aaronbeekay/Battery-balancer/Design/HMI/HMI behavior.xlsx

HMI inputs/outputs
Inputs
 | WAIT | ERROR | CHARGE | BALANCE | CHARGE+BALANCE
MODE SELECT switch (CHARGE / BALANCE / CHARGE + BALANCE) | No effect | No effect | Change mode to selected mode
START pushbutton | Change mode to selected mode | No effect
STOP pushbutton | No effect | No effect | Change mode to WAIT
ERROR pushbutton | No effect | Clear errors Change mode to WAIT | No effect
LCD up | Cycle LCD page up |  | Cycle LCD page up
LCD down | Cycle LCD page down |  | Cycle LCD page down
Outputs
ERROR indicator | Off | On | Off
START indicator | Off | Off | On
STOP indicator | On | On | Off
CHARGE indicator | State controlled by charge controller (green if charge complete; red if charging)
BALANCE indicator | State controlled by balance controller (green if balance complete; red if balancing)
Balancing relays | Disabled | Disabled | Disabled | Enabled | Enabled
Bulk charge | Disabled | Disabled | Enabled | Disabled | Enabled
