aaronbeekay/Battery-balancer/Hardware/Front panel/Calculations/Thermistor calculations.xlsx

Typically the team uses NTC thermistors with parameters similar to the Cantherm CWF1B103H3380: | Thermistor parameters
 | β value | 3380 | K
 | Resistance at 25º C | 10000 | ohm
 | Calculated parameters
 | R_inf | 0.11929 | ohm
We will define a range of temperatures that we expect to measure: | Design temperature range
 | Minimum measurable temperature | -40.00 | ºC
 | Maximum measurable temperature | 125 | ºC
which sets the upper and lower bounds on our thermistor resistance: | Thermistor resistance range
 | Minimum thermistor resistance | 579.9997447 | ohm
 | Maximum thermistor resistance | 235830.7559 | ohm
For now we will hard code our series resistor (we cheated and calculated it in Mathematica) | Scaling resistor
 | Rs (series resistance) | 10000 | ohm
For our first-order RC filter, we should be aware that the effective corner frequency will change with the temperature. We can set a desired corner frequency at the midpoint of our temperature range… | Filter capacitor
 | Desired corner frequency | 1 | Hz
 | at… | 42.5 | ºC
 | Effective input impedance | 3478.48 | ohm
 | Required capacitance | 45.754 | uF
… then check the corner frequency at our temperature limits. | Filter behavior
 | Effective input impedance @ max temp | 548.20 | ohm
 | Effective input impedance @ min temp | 9593.22 | ohm
 | Corner frequency at max temp | 6.345 | Hz
 | Corner frequency at min temp | 0.363 | Hz
Remember -- at minimum, we must always sample above 2x our max corner frequency. And if we don't do any DSP on the microcontroller, we must also send out CAN data at >2x the corner frequency.
