aaronbeekay/Battery-balancer/Hardware/Front panel/Calculations/SPIBRR calculations.xlsx

Sheet: SPICLK
SPIBRR | LOSPCP
 | 000 | 001 | 010 | 011 | 100 | 101 | 110 | 111
 | SYSCLKOUT/1 | SYSCLKOUT/2 | SYSCLKOUT/4 | SYSCLKOUT/6 | SYSCLKOUT/8 | SYSCLKOUT/10 | SYSCLKOUT/12 | SYSCLKOUT/14
3 | 15000000 | 7500000 | 3750000 | 2500000 | 1875000 | 1500000 | 1250000 | 1071428.571
4 | 12000000 | 6000000 | 3000000 | 2000000 | 1500000 | 1200000 | 1000000 | 857142.8571
5 | 10000000 | 5000000 | 2500000 | 1666666.667 | 1250000 | 1000000 | 833333.3333 | 714285.7143
6 | 8571428.571 | 4285714.286 | 2142857.143 | 1428571.429 | 1071428.571 | 857142.8571 | 714285.7143 | 612244.898
7 | 7500000 | 3750000 | 1875000 | 1250000 | 937500 | 750000 | 625000 | 535714.2857
8 | 6666666.667 | 3333333.333 | 1666666.667 | 1111111.111 | 833333.3333 | 666666.6667 | 555555.5556 | 476190.4762
9 | 6000000 | 3000000 | 1500000 | 1000000 | 750000 | 600000 | 500000 | 428571.4286
10 | 5454545.455 | 2727272.727 | 1363636.364 | 909090.9091 | 681818.1818 | 545454.5455 | 454545.4545 | 389610.3896
11 | 5000000 | 2500000 | 1250000 | 833333.3333 | 625000 | 500000 | 416666.6667 | 357142.8571
12 | 4615384.615 | 2307692.308 | 1153846.154 | 769230.7692 | 576923.0769 | 461538.4615 | 384615.3846 | 329670.3297
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
