aaronbeekay/Battery-balancer/CAD/Front panel/Front panel subcomponents/GPB527C2L02BG1 switch components/side view.PNG

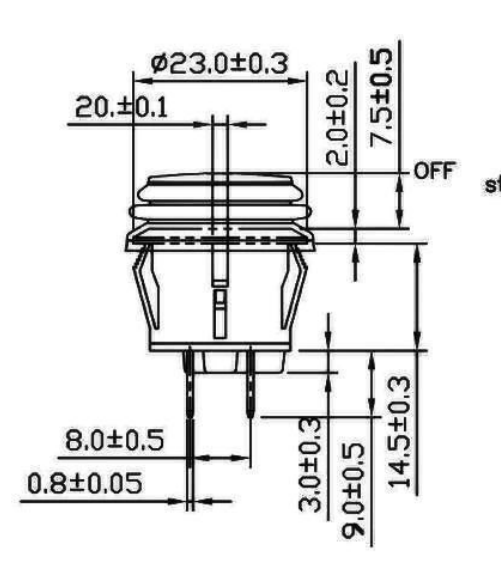
CAD/Front panel/Front panel subcomponents/GPB527C2L02BG1 switch components/side view.PNG
