aaronbeekay/Battery-balancer/CAD/Front panel/Front panel.SLDASM

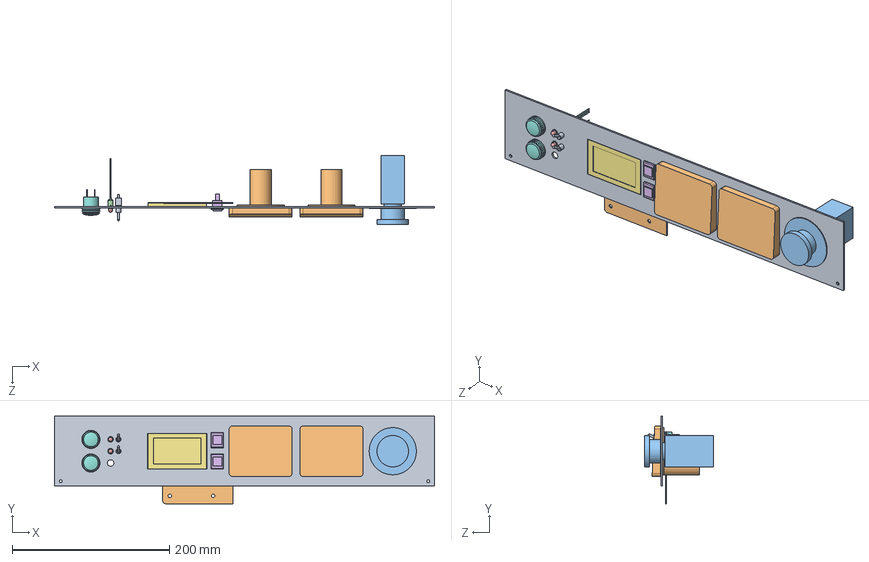
[picture p2: CAD file, 2016-03-22]
CAD/Front panel/Front panel.SLDASM
482.6 x 111.2 x 87.5 mm
Front panel
Front panel PCB
GCX3131 E-stop button
PM5-3_A1 x 2
LED_5mm x 2
TP11J81ZQE22 pushbutton x 2
LCD
GPB527C2L02BG1 pushbutton switch x 2
M2011SS1W01 toggle switch x 2
Panel meter PM89 x 2
