aaronbeekay/Battery-balancer/CAD/Balancer/Electrical components/SUNON Fan Assembly.SLDASM

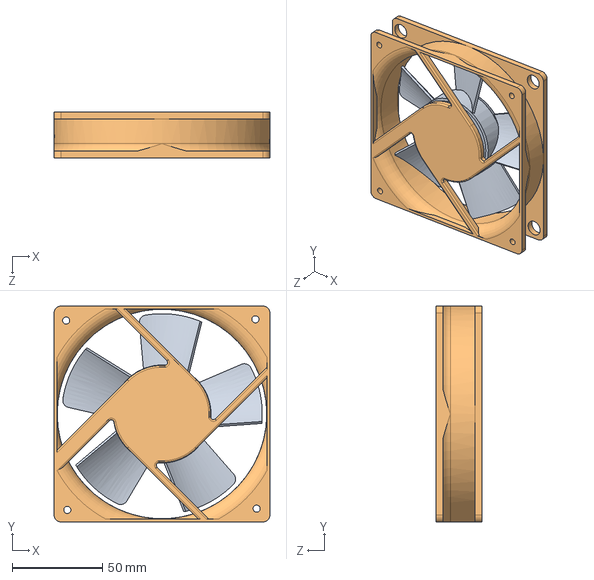
[picture p4: CAD file, 2016-03-11]
CAD/Balancer/Electrical components/SUNON Fan Assembly.SLDASM
119.8 x 119.8 x 25.6 mm
Fan
Fan Housing
