aaronbeekay/Battery-balancer/CAD/Front panel/Front panel subcomponents/PM53-YGW12.0 LED indicator.SLDASM

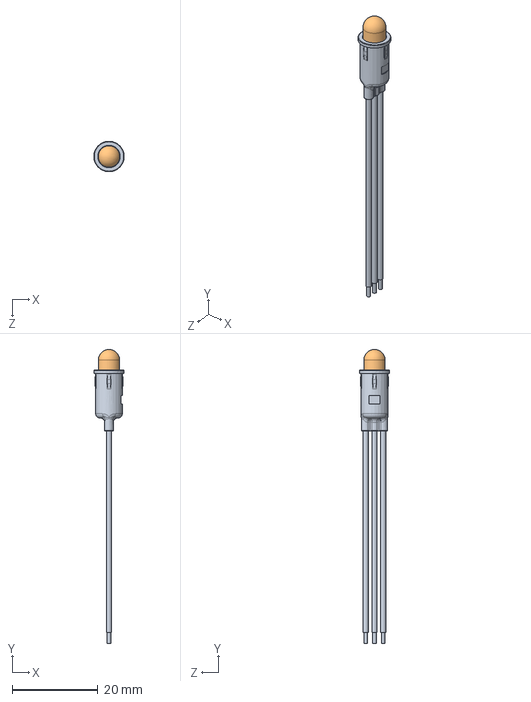
[picture p7: CAD file, 2016-01-27]
CAD/Front panel/Front panel subcomponents/PM53-YGW12.0 LED indicator.SLDASM
7.11 x 68.6 x 7.11 mm
PM5-3_A1
LED_5mm
