aaronbeekay/Battery-balancer/CAD/Balancer/Electrical components/Ohmite L25J1R0E.SLDPRT

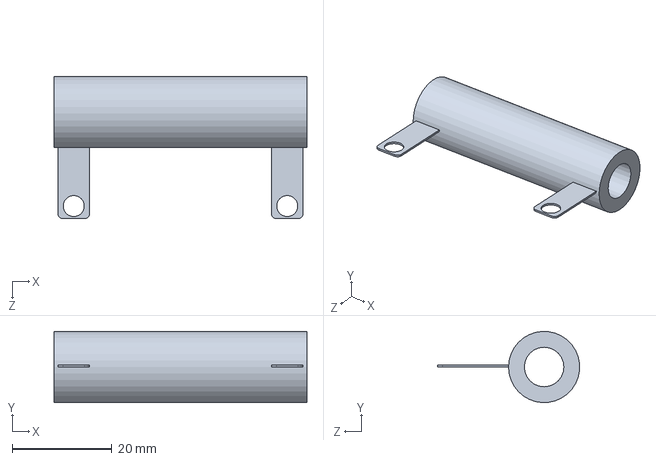
[picture p8: CAD file, 2016-03-11]
CAD/Balancer/Electrical components/Ohmite L25J1R0E.SLDPRT
50.8 x 14.3 x 28.6 mm
