aaronbeekay/Battery-balancer/CAD/Balancer/Structural components/Resistor side wall.SLDPRT

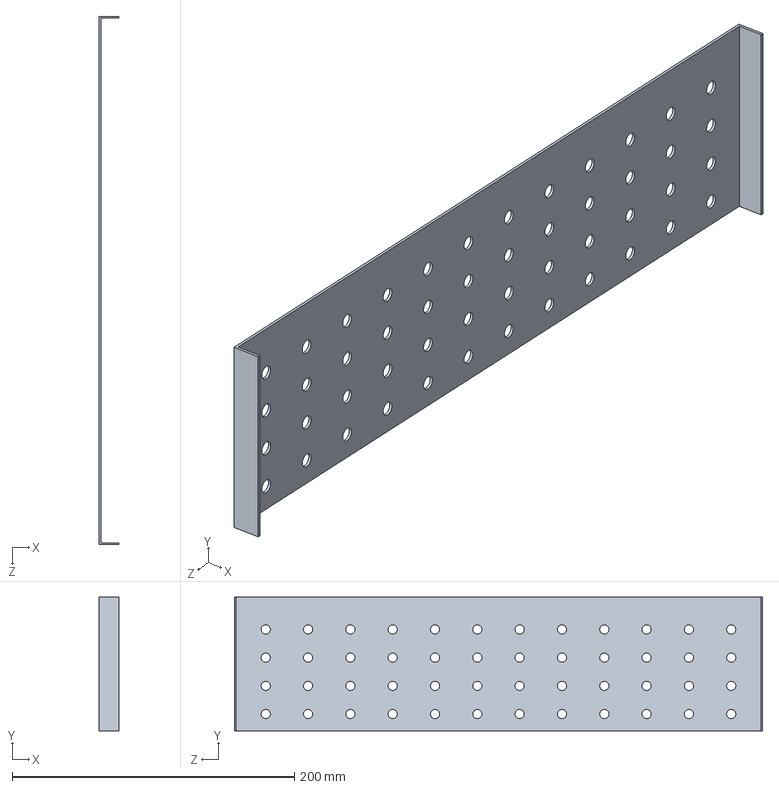
[picture p9: CAD file, 2016-03-11]
CAD/Balancer/Structural components/Resistor side wall.SLDPRT
14.0 x 95.0 x 374.5 mm
