aaronbeekay/Battery-balancer/CAD/Front panel/Front panel subcomponents/Front panel PCB subcomponents/B4B-XH-A 4pos vert.SLDPRT

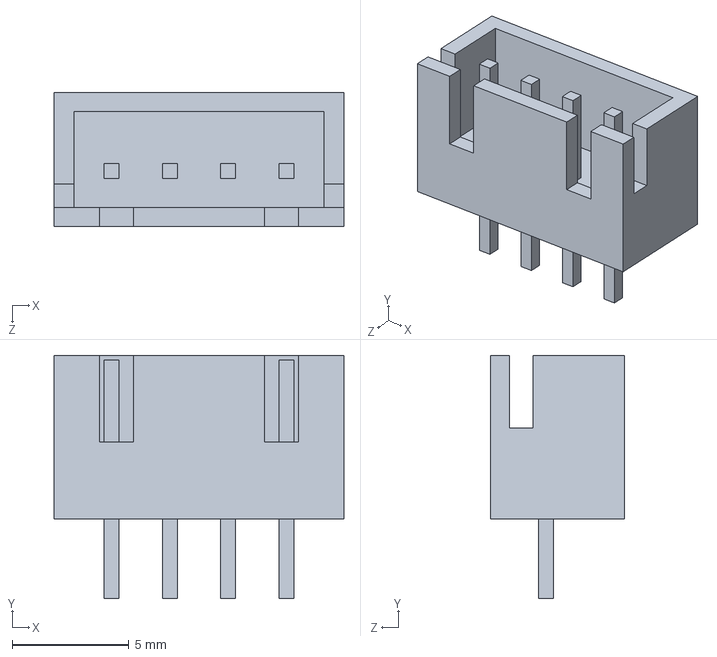
[picture p10: CAD file, 2016-03-11]
CAD/Front panel/Front panel subcomponents/Front panel PCB subcomponents/B4B-XH-A 4pos vert.SLDPRT
12.4 x 10.4 x 5.75 mm
