aaronbeekay/Battery-balancer/CAD/Front panel/Front panel subcomponents/Front panel.SLDPRT

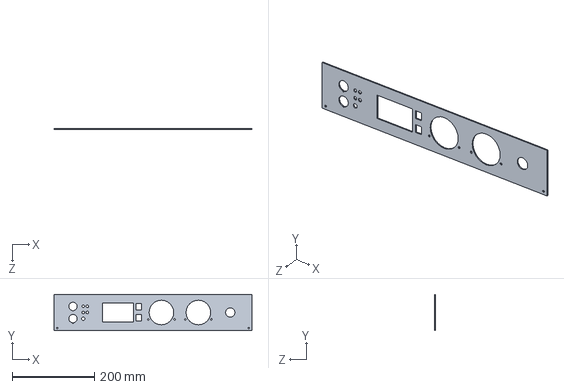
[picture p11: CAD file, 2016-03-22]
CAD/Front panel/Front panel subcomponents/Front panel.SLDPRT
482.6 x 88.9 x 2.10 mm
