aaronbeekay/Battery-balancer/CAD/Front panel/Printing subcomponents/Foot thing.SLDPRT

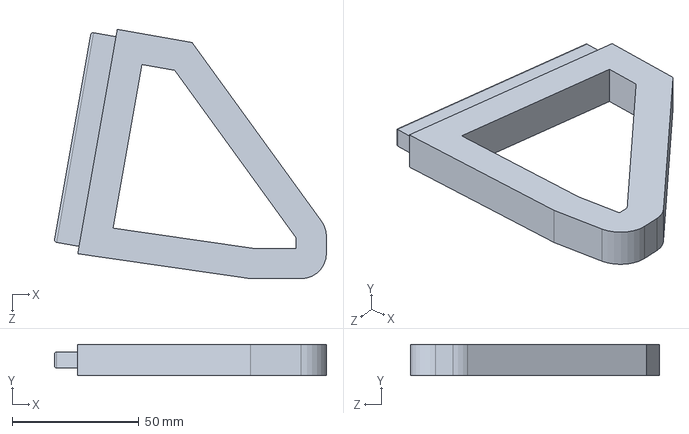
[picture p12: CAD file, 2016-03-11]
CAD/Front panel/Printing subcomponents/Foot thing.SLDPRT
107.4 x 12.2 x 98.5 mm
