aaronbeekay/Battery-balancer/CAD/Front panel/Front panel subcomponents/Front panel PCB subcomponents/B2B-XH-A 2pos vert.SLDPRT

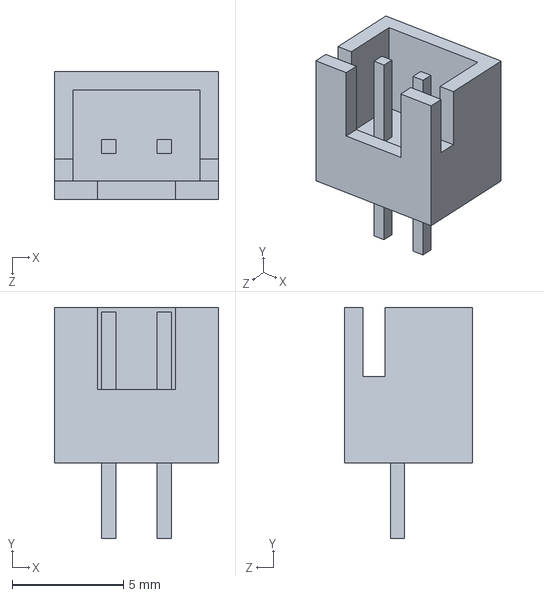
[picture p13: CAD file, 2016-03-11]
CAD/Front panel/Front panel subcomponents/Front panel PCB subcomponents/B2B-XH-A 2pos vert.SLDPRT
7.40 x 10.4 x 5.75 mm
