aaronbeekay/Battery-balancer/CAD/Front panel/Front panel subcomponents/Panel meter PM89.SLDPRT

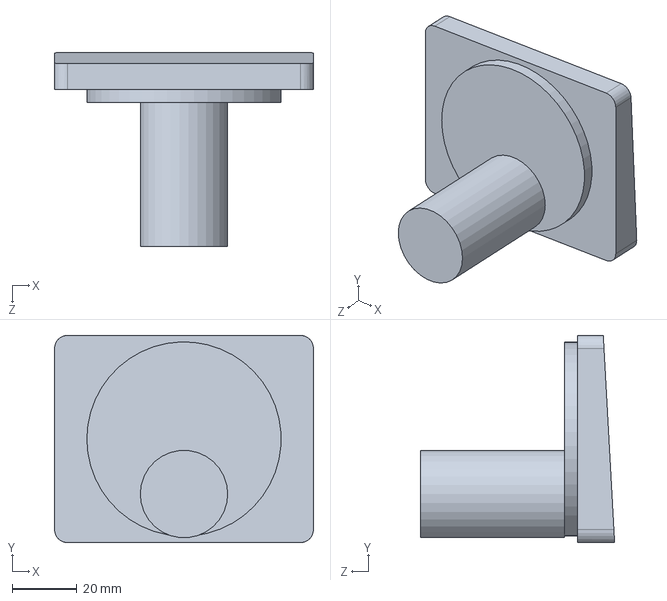
[picture p14: CAD file, 2016-03-22]
CAD/Front panel/Front panel subcomponents/Panel meter PM89.SLDPRT
80.0 x 64.0 x 60.0 mm
