aaronbeekay/Battery-balancer/CAD/Front panel/Front panel subcomponents/Front panel PCB mount.SLDPRT

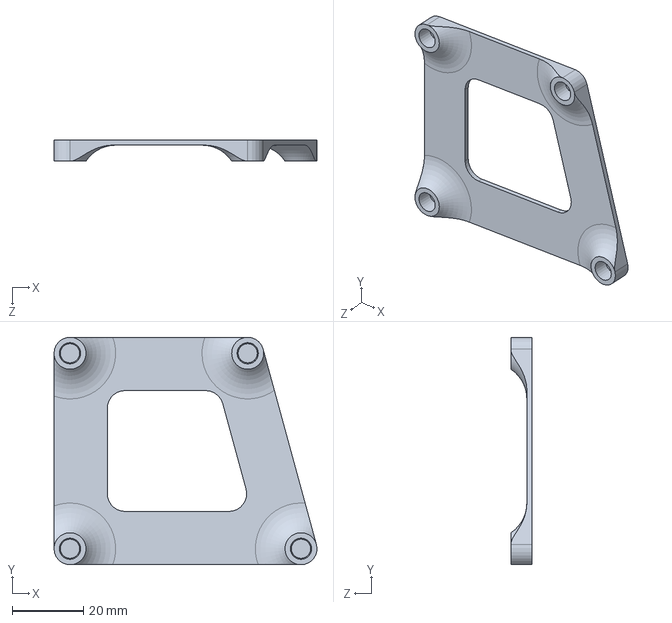
[picture p15: CAD file, 2016-03-11]
CAD/Front panel/Front panel subcomponents/Front panel PCB mount.SLDPRT
74.0 x 64.0 x 6.00 mm
