aaronbeekay/Battery-balancer/CAD/Front panel/Front panel subcomponents/Front panel PCB subcomponents/B2B-XH-A 2pos RA.SLDPRT

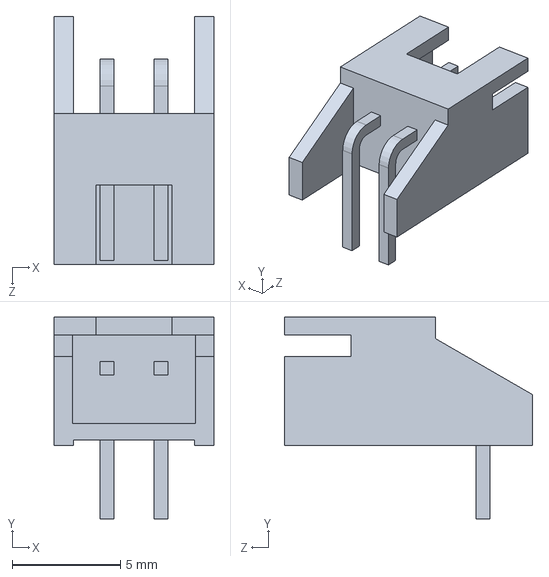
[picture p16: CAD file, 2016-03-11]
CAD/Front panel/Front panel subcomponents/Front panel PCB subcomponents/B2B-XH-A 2pos RA.SLDPRT
7.40 x 9.35 x 11.5 mm
