aaronbeekay/Battery-balancer/CAD/Front panel/Front panel subcomponents/Front panel PCB subcomponents/B3B-XH-A 3pos vert.SLDPRT

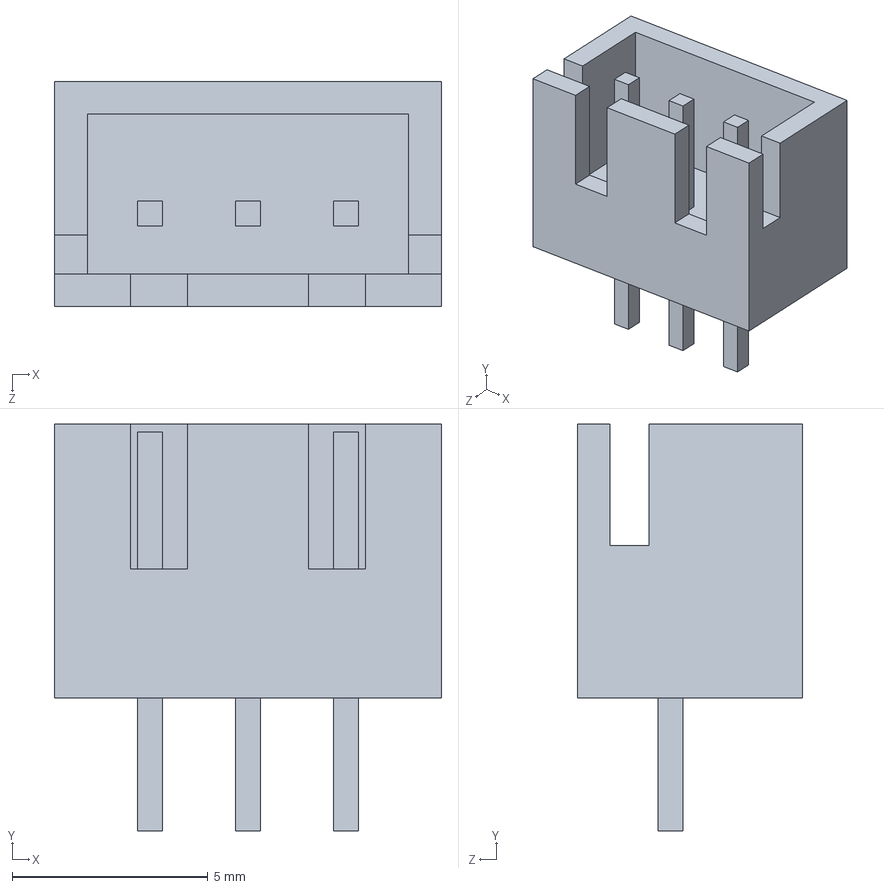
[picture p17: CAD file, 2016-03-11]
CAD/Front panel/Front panel subcomponents/Front panel PCB subcomponents/B3B-XH-A 3pos vert.SLDPRT
9.90 x 10.4 x 5.75 mm
