aaronbeekay/Battery-balancer/CAD/Front panel/Front panel subcomponents/GPB527C2L02BG1 pushbutton switch.SLDPRT

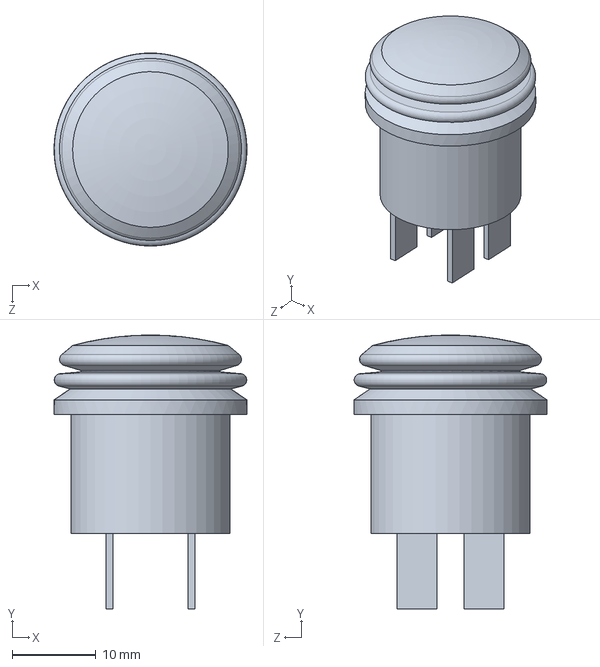
[picture p18: CAD file, 2016-03-11]
CAD/Front panel/Front panel subcomponents/GPB527C2L02BG1 pushbutton switch.SLDPRT
23.0 x 32.7 x 23.0 mm
