aaronbeekay/Battery-balancer/CAD/Front panel/Front panel subcomponents/GCX3131 E-stop button.SLDPRT

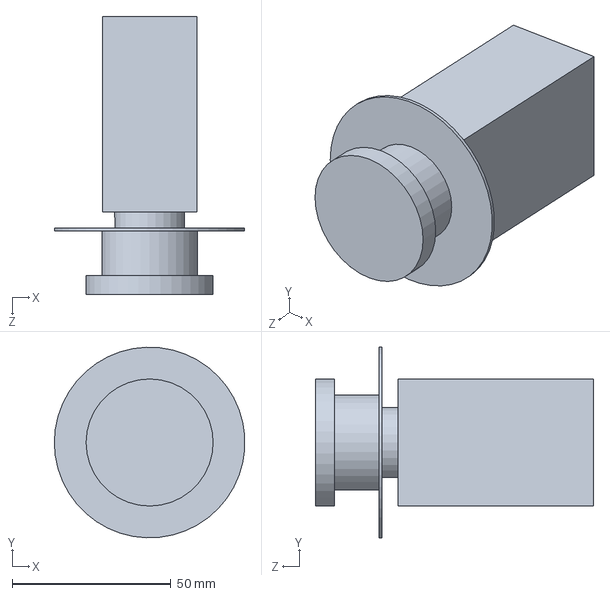
[picture p23: CAD file, 2016-01-27]
CAD/Front panel/Front panel subcomponents/GCX3131 E-stop button.SLDPRT
59.9 x 60.0 x 87.5 mm
