aaronbeekay/Battery-balancer/CAD/Front panel/Front panel subcomponents/TP11J81ZQE22 pushbutton.SLDPRT

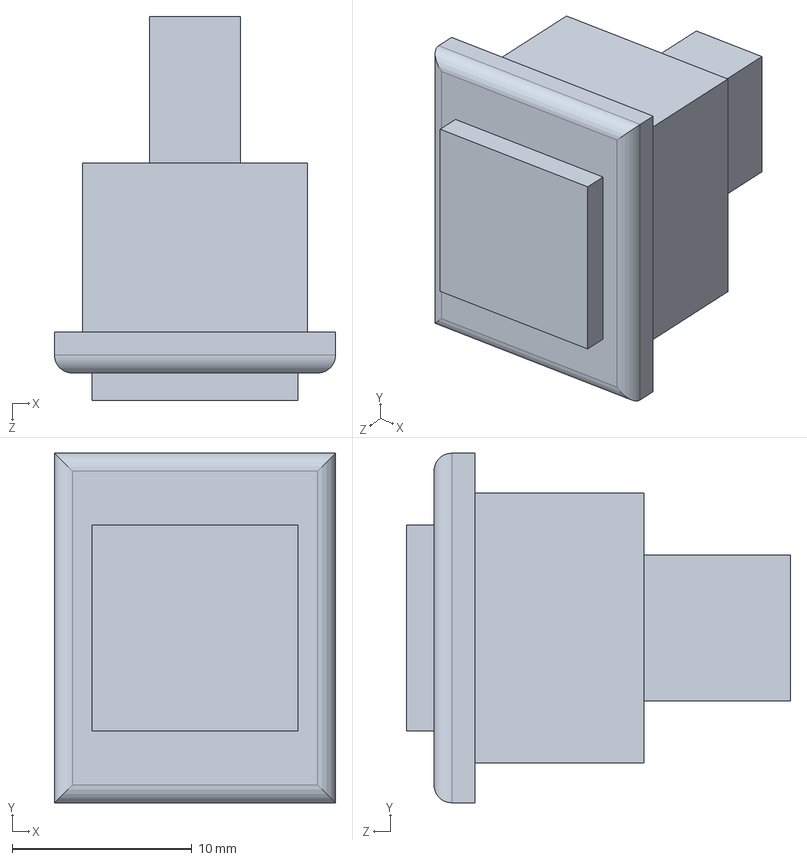
[picture p24: CAD file, 2016-01-27]
CAD/Front panel/Front panel subcomponents/TP11J81ZQE22 pushbutton.SLDPRT
15.6 x 19.4 x 21.3 mm
