aaronbeekay/Battery-balancer/CAD/Front panel/Front panel subcomponents/GCX3320 selector switch.sldprt

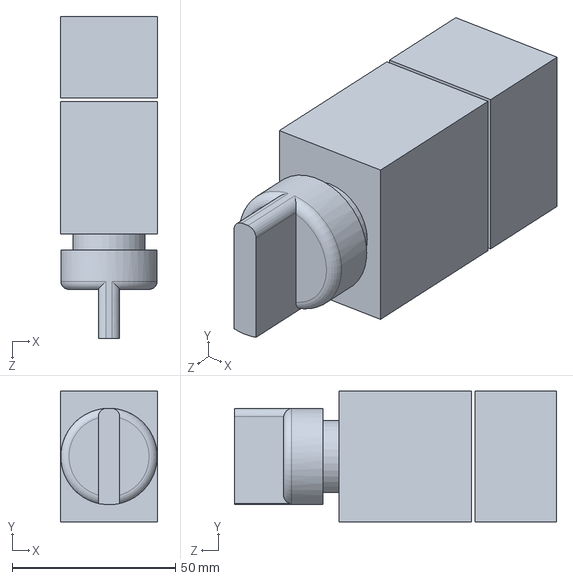
[picture p25: CAD file, 2016-01-27]
CAD/Front panel/Front panel subcomponents/GCX3320 selector switch.sldprt
29.8 x 40.0 x 98.5 mm
