aaronbeekay/Battery-balancer/CAD/Front panel/Front panel subcomponents/GCX3202 pushbutton ind.SLDPRT

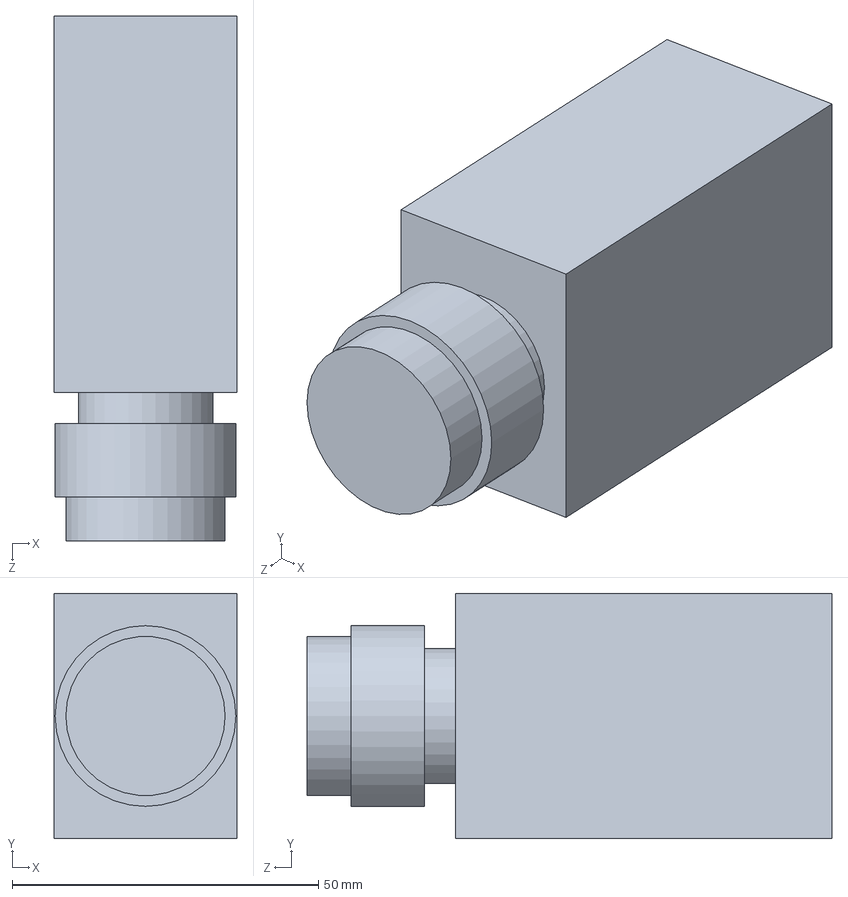
[picture p26: CAD file, 2016-01-27]
CAD/Front panel/Front panel subcomponents/GCX3202 pushbutton ind.SLDPRT
29.8 x 40.0 x 85.7 mm
