aaronbeekay/Battery-balancer/(list of files, cad)

Other CAD files:
CAD/Balancer/Fan Housing.sldprt
CAD/Balancer/Electrical components/Fan Housing.sldprt
CAD/Balancer/Fan.sldprt
CAD/Front panel/PM5-3_A1.sldprt
CAD/Front panel/LED_5mm.sldprt
CAD/Balancer/Electrical components/Fan.sldprt
CAD/Front panel/Front panel subcomponents/PM5-3_A1.sldprt
CAD/Front panel/Front panel subcomponents/LED_5mm.sldprt
CAD/Balancer/Electrical components/205840-3 CPC Series 2 28pos.SLDPRT
CAD/Balancer/Electrical components/787610-1 CPC panel mnt 37 pos.SLDPRT
CAD/Front panel/Front panel subcomponents/Front panel PCB mount.STL
CAD/Front panel/Front panel subcomponents/Front panel PCB.SLDPRT
CAD/Front panel/Front panel subcomponents/Front panel print.STL
CAD/Front panel/Front panel subcomponents/Front panel.SLDDRW
CAD/Front panel/Front panel.DXF
CAD/Front panel/Front panel.SLDDRW
CAD/Front panel/Printing subcomponents/Foot thing.STL
