aaronbeekay/Battery-balancer/Hardware/Front panel/Front panel PCB - top.pdf

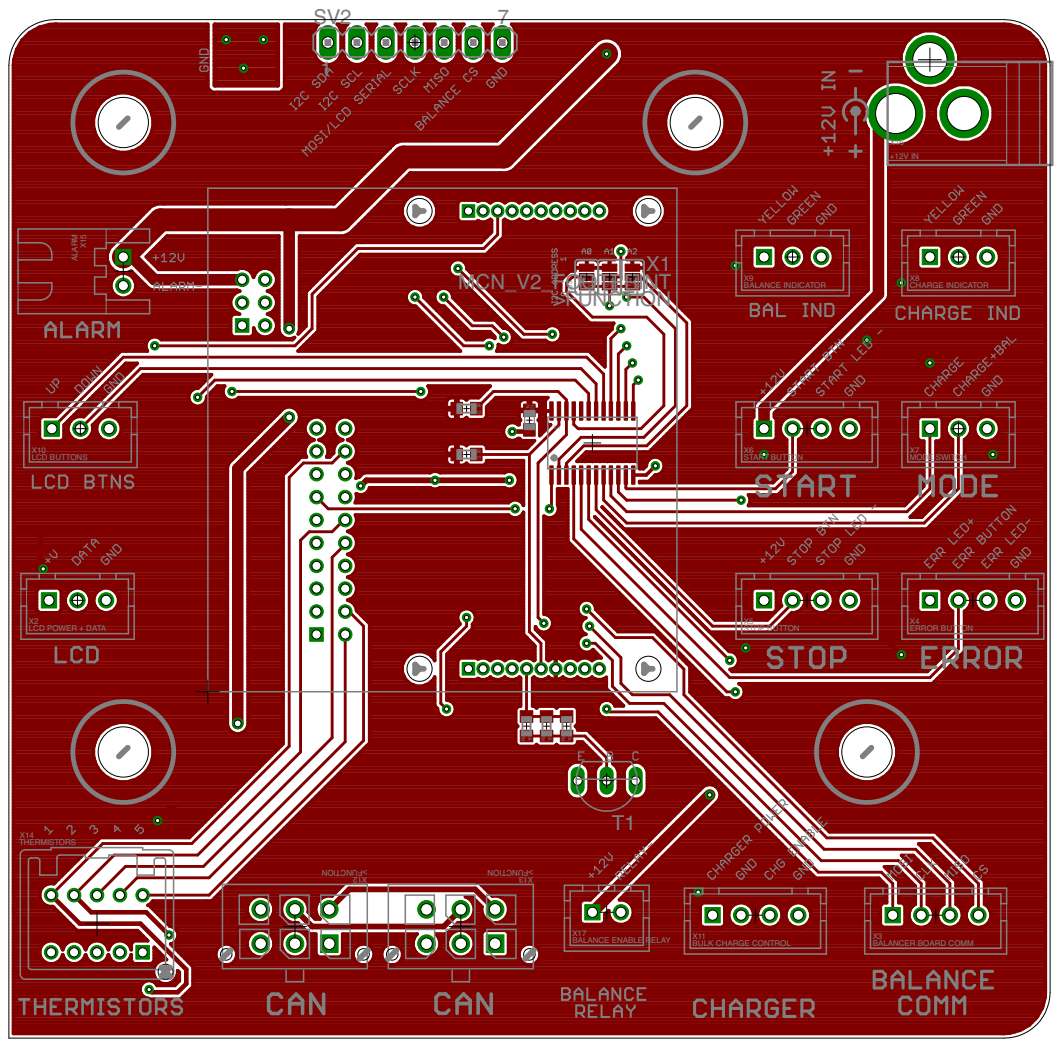
[picture p27: page 1]

X10 | 2.2k X6 | X7
LCD BUTTONS | R11 | START BUTTON | MODE SWITCH

BALANCE ENABLE RELAY X11 BALANCER BOARD COMM X3 BULK CHARGE CONTROL
