aaronbeekay/Battery-balancer/Hardware/Front panel/Front panel PCB schematic.pdf

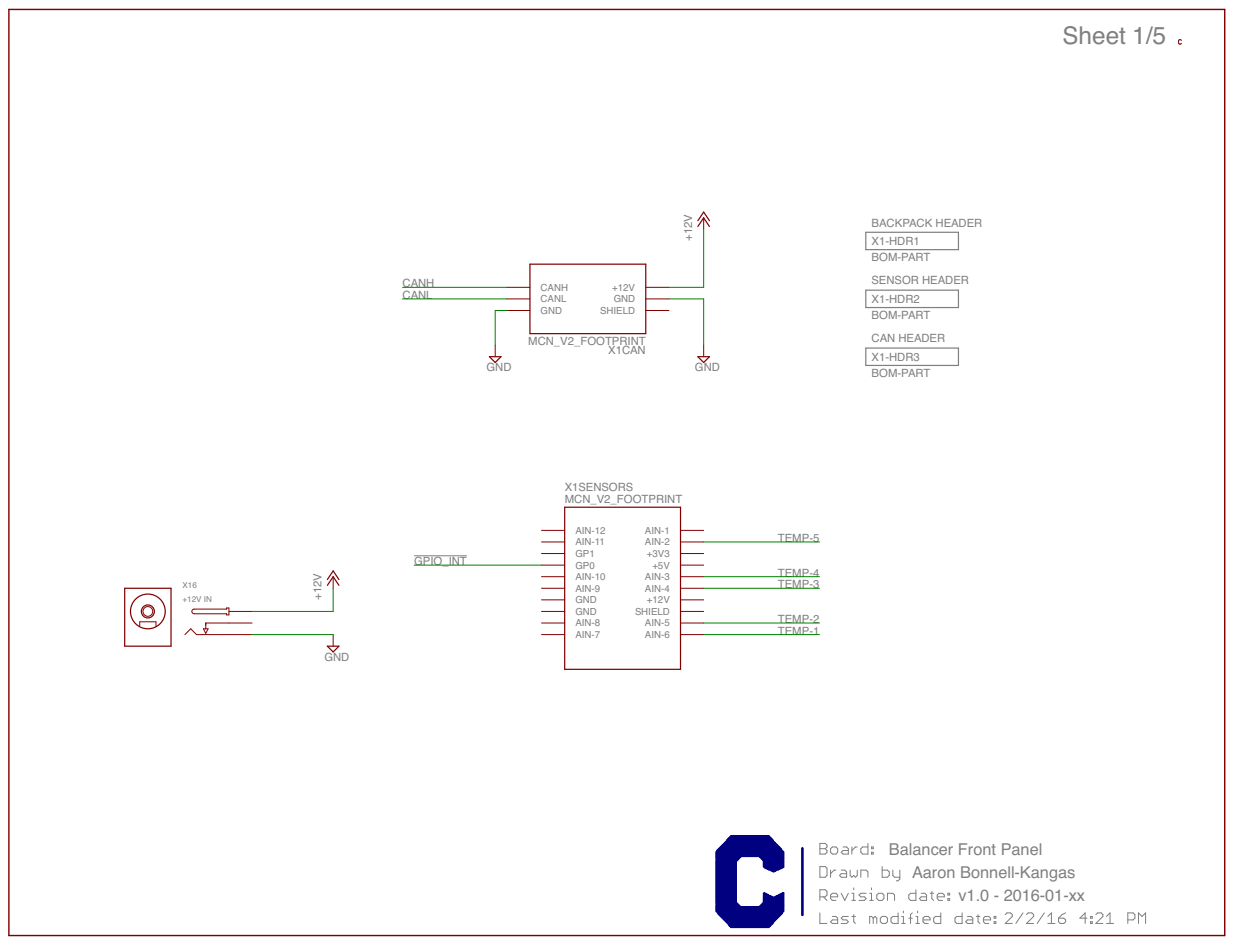
[picture p28: page 1]

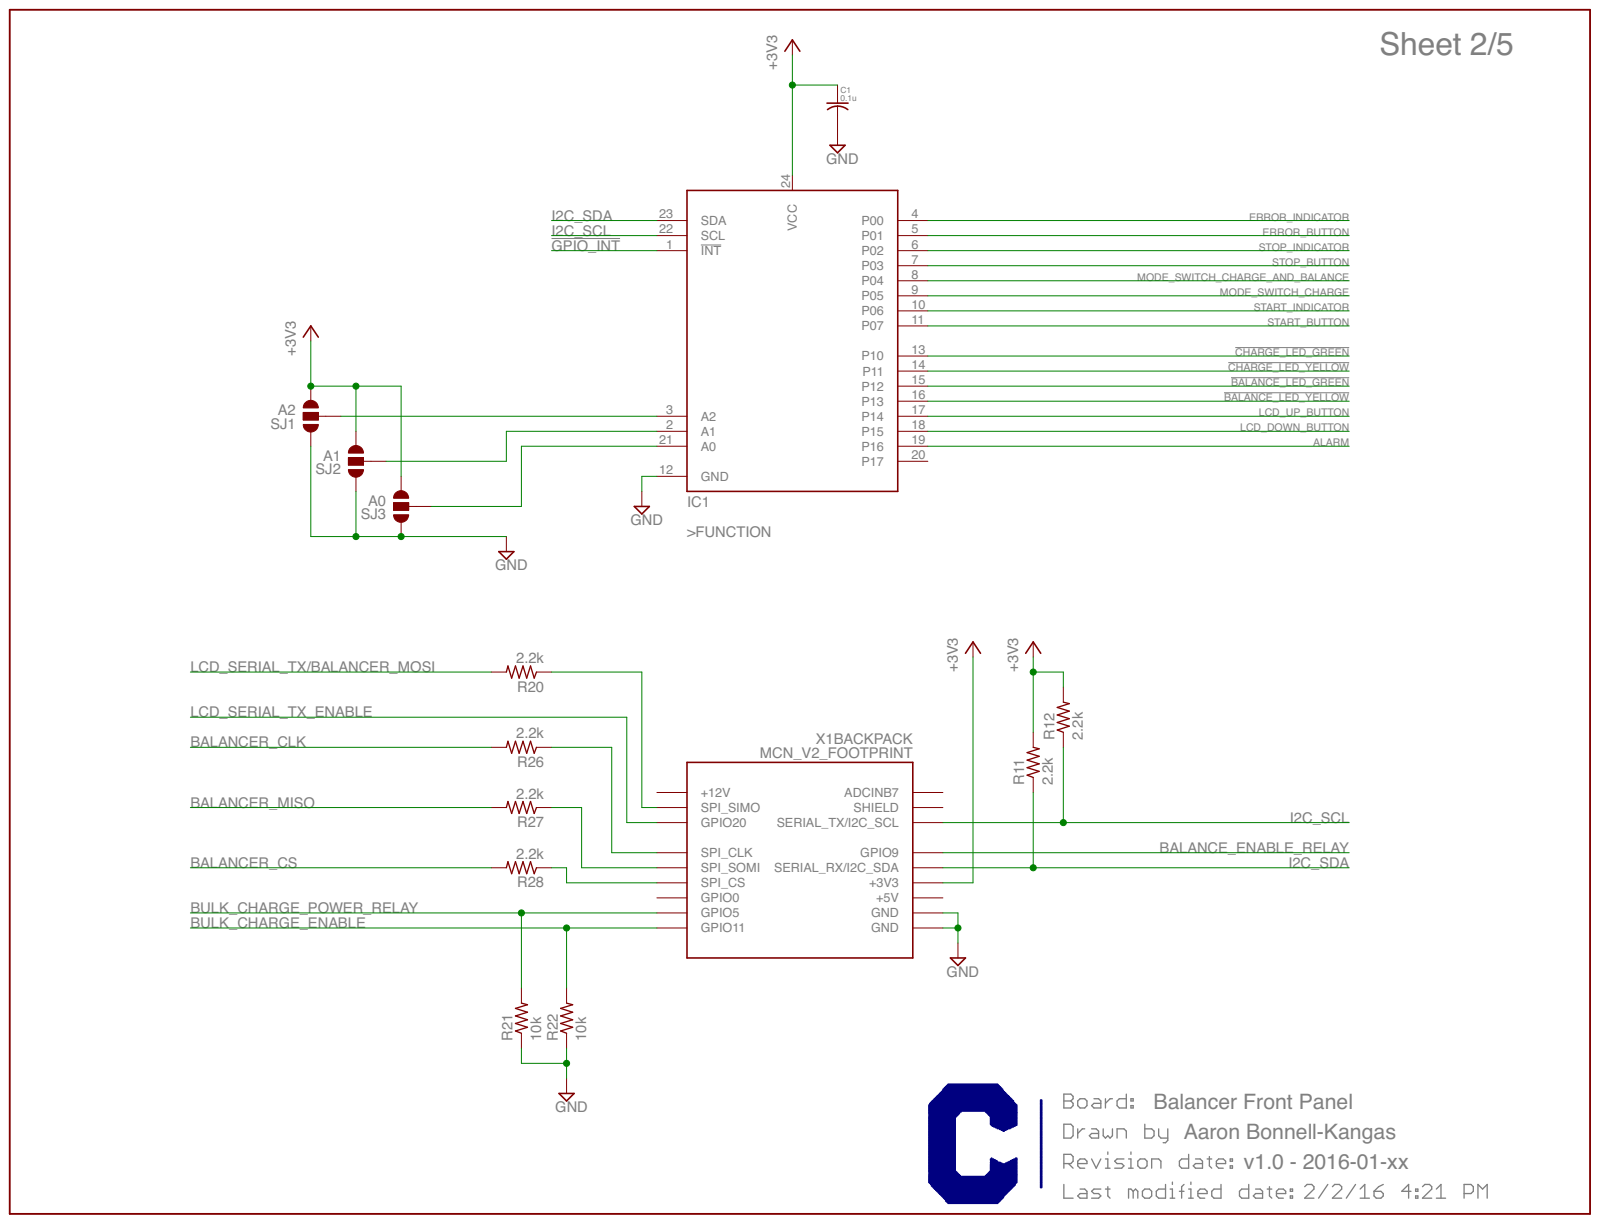
[picture p29: page 2]

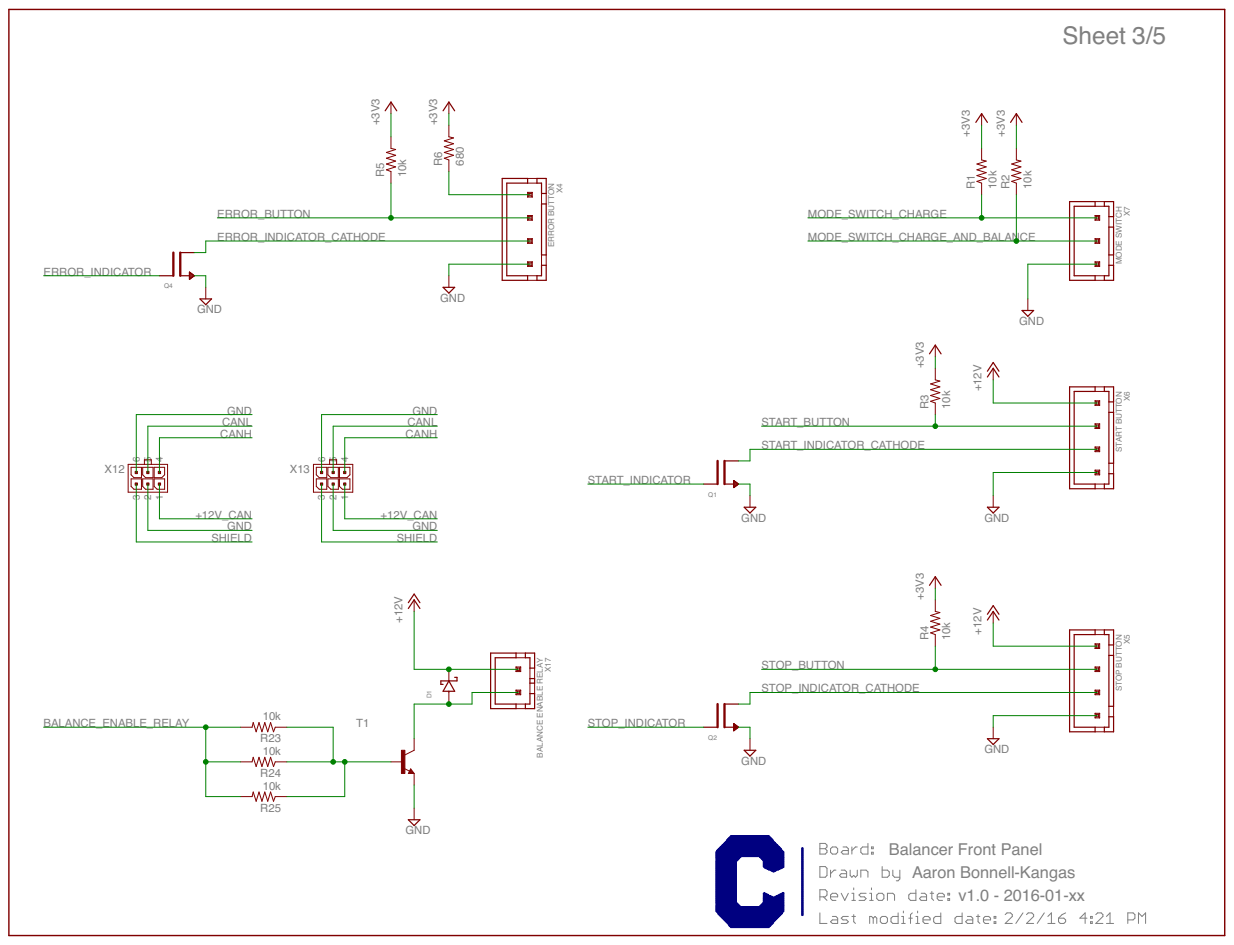
[picture p30: page 3]

STOP BUTTON START BUTTON MODE SWITCH

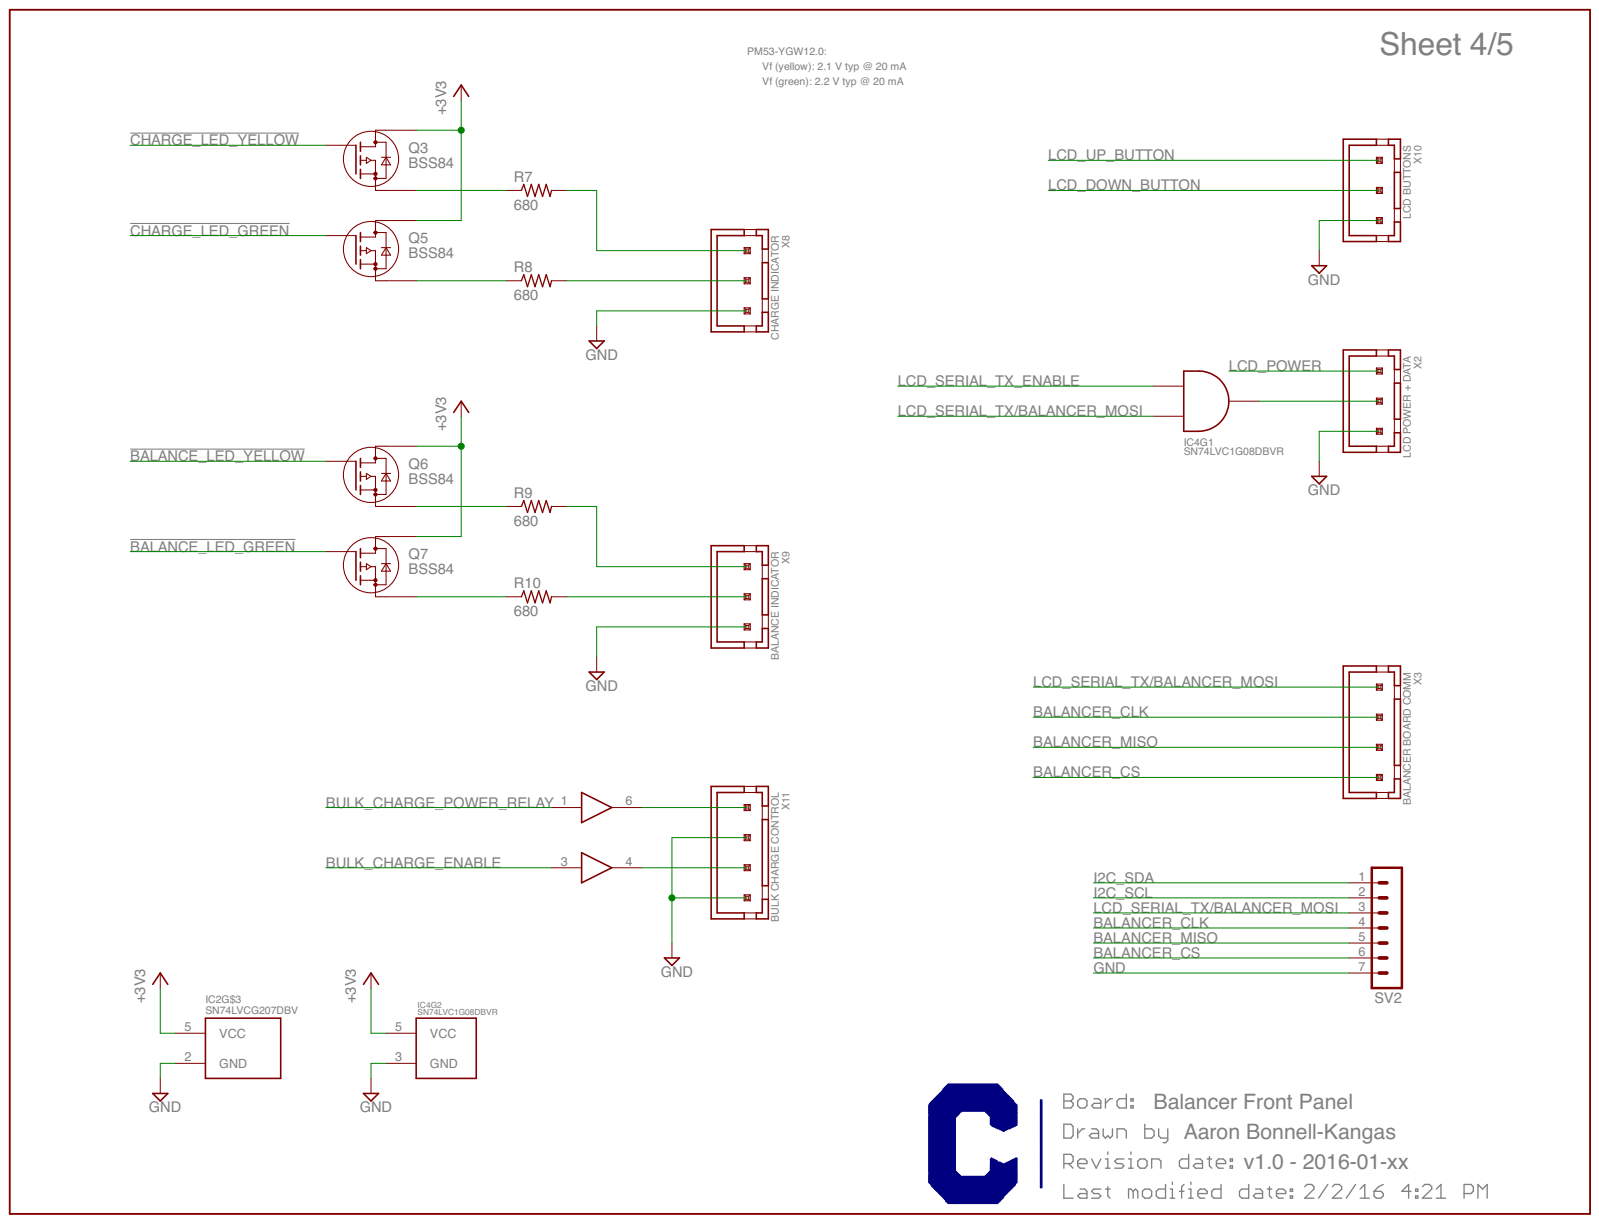
[picture p31: page 4]

Vf (yellow): 2.1 V typ @ 20 mA
Vf (green): 2.2 V typ @ 20 mA

CHARGE INDICATOR BALANCE INDICATOR

LCD POWER + DATA BALANCER BOARD COMM

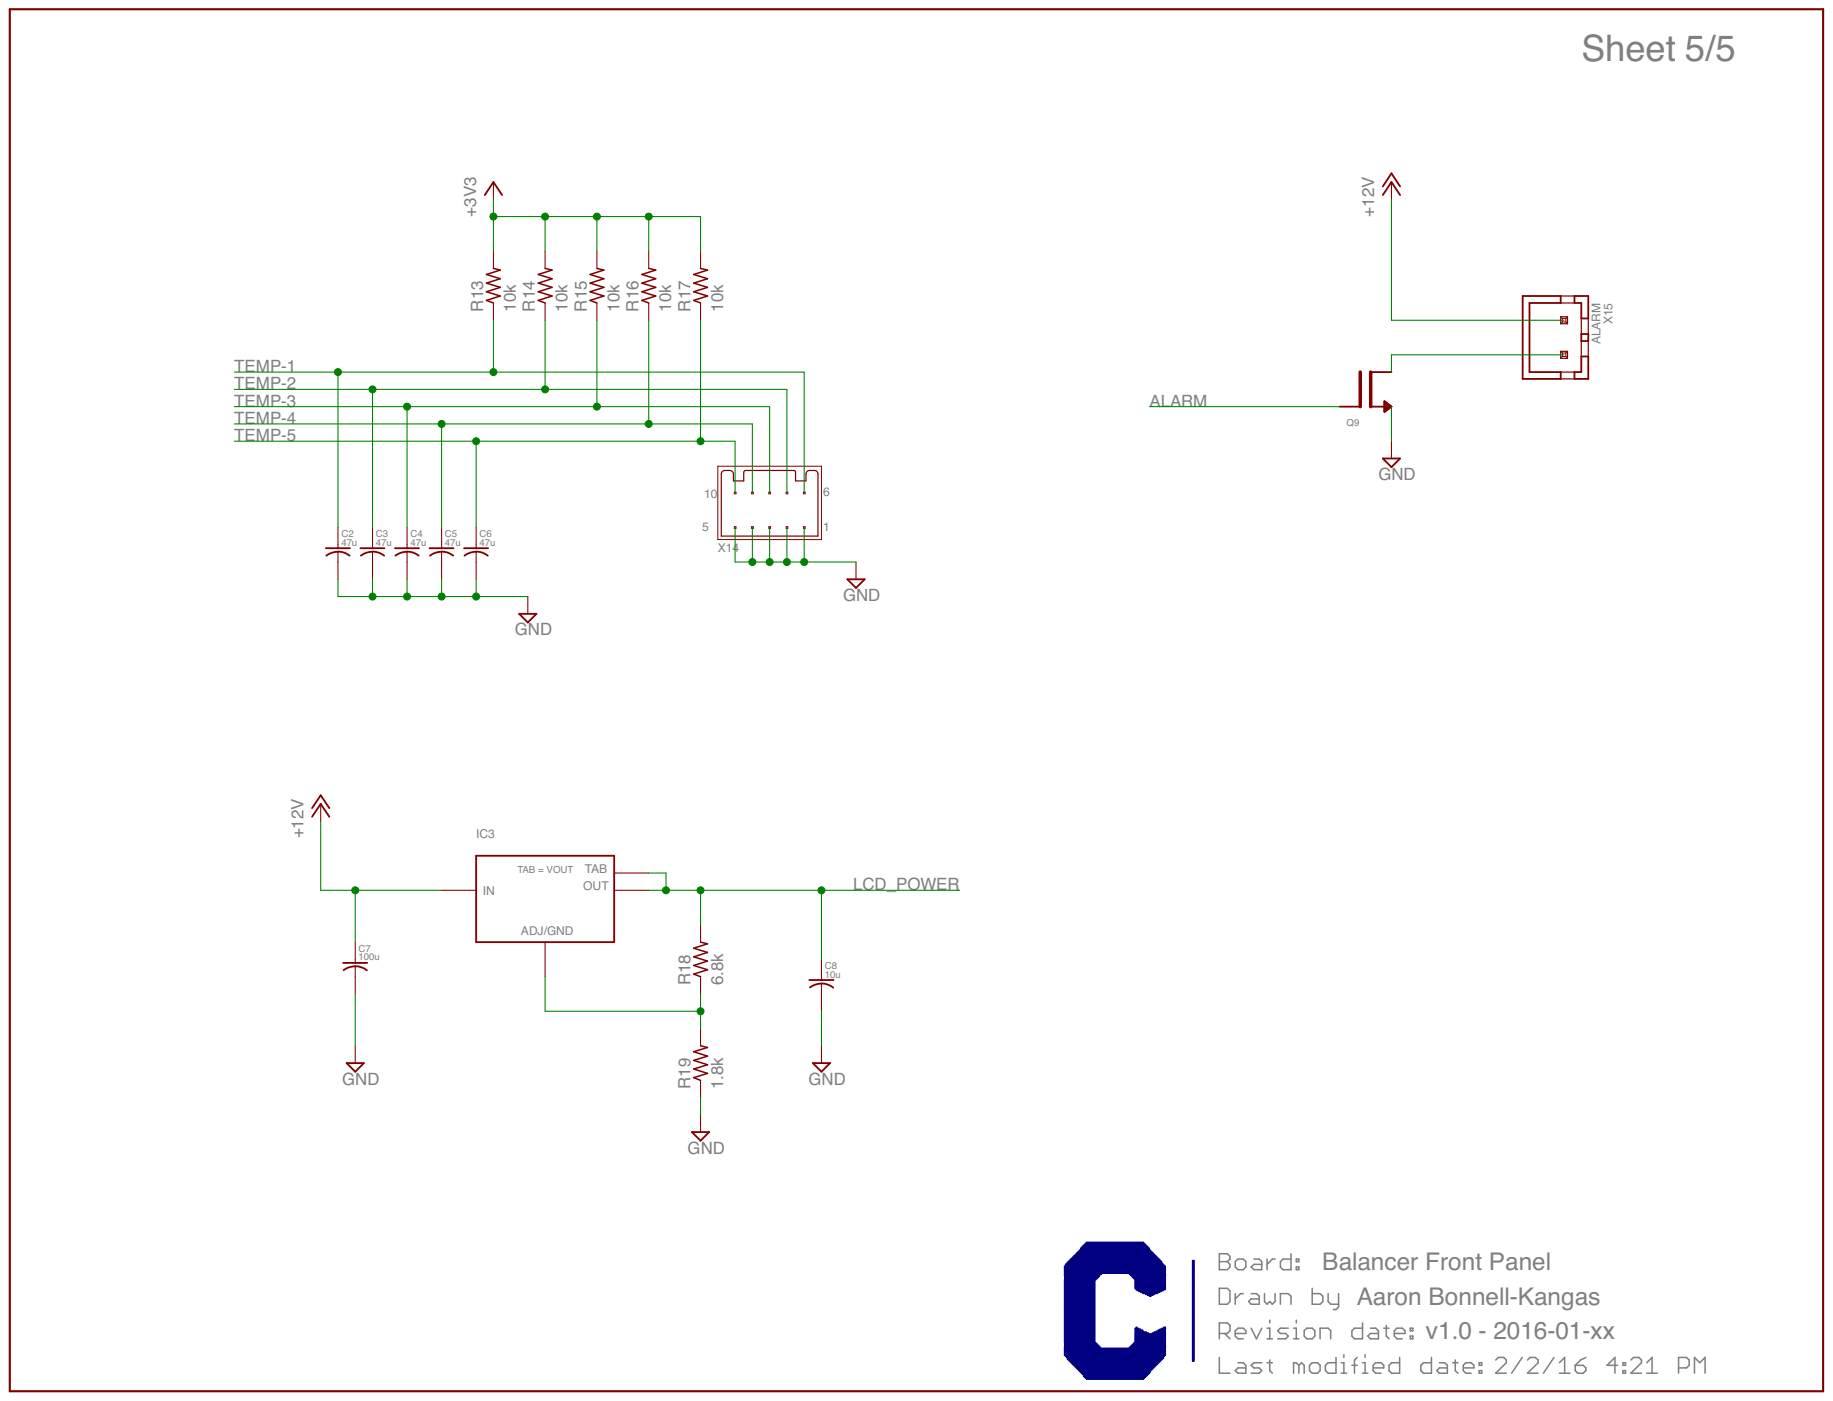
[picture p32: page 5]

TAB = VOUT TAB
ADJ/GND OUT IN
