aaronbeekay/Battery-balancer/CAD/Front panel/Front panel.PDF

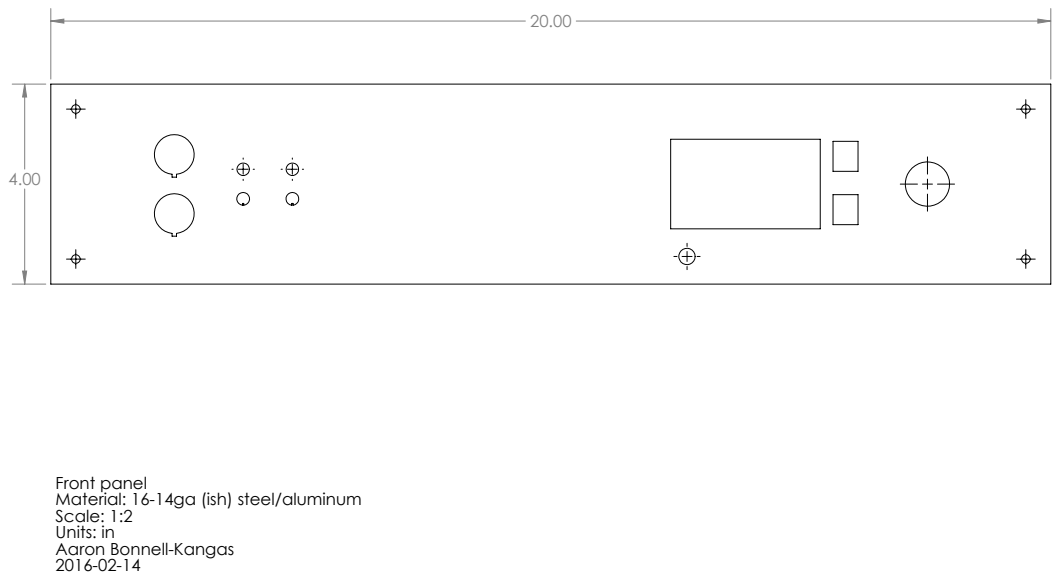
[picture p33: page 1]

Front panel
Material: 16-14ga (ish) steel/aluminum
Scale: 1:2
Units: in
Aaron Bonnell-Kangas
