aaronbeekay/Battery-balancer/CAD/Front panel/Front panel subcomponents/Front panel.PDF

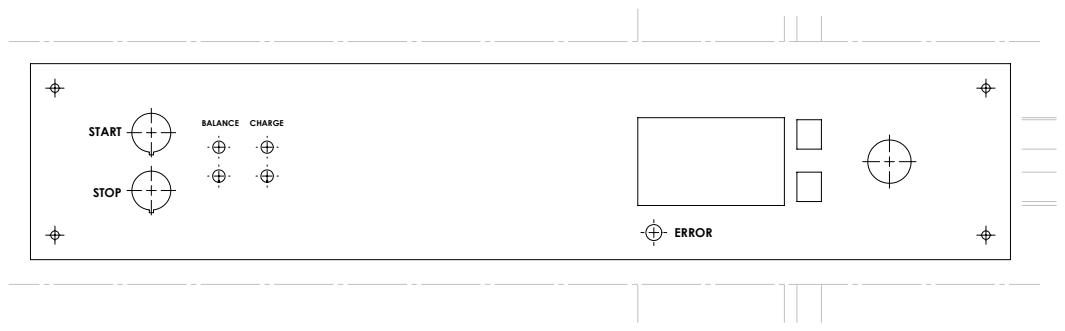
[picture p34: page 1]
BALANCE CHARGE
