aaronbeekay/Battery-balancer/Hardware/Front panel/Front panel PCB - bottom.pdf

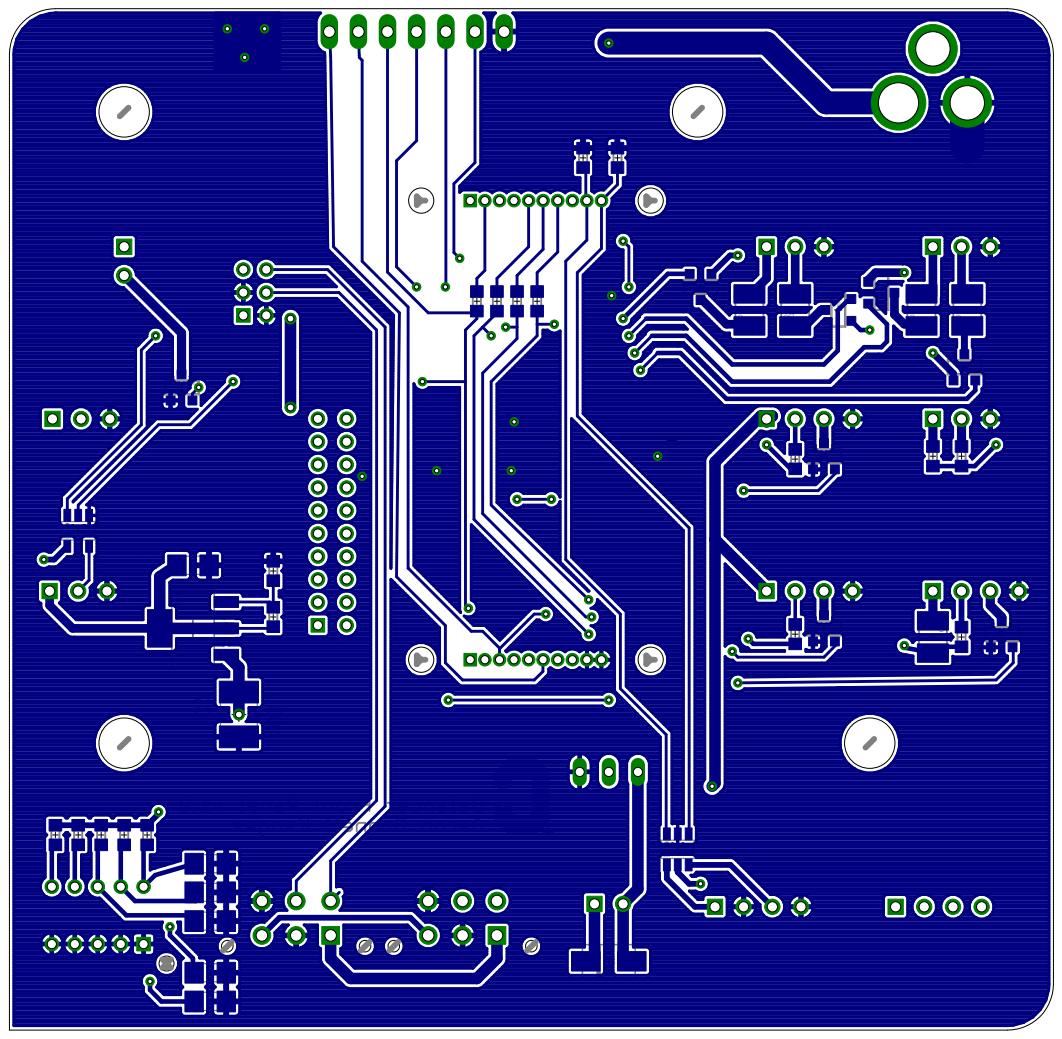
[picture p35: page 1]
