aaronbeekay/Battery-balancer/Software/Battery Balancer/Project Source/Error.c

/*
 * Error.c
 *
 *  Created on: Jan 26, 2016
 *      Author: Sean Harrington
 */


//-----------------------------------------------------------------------
// Global variables
//-----------------------------------------------------------------------

//-----------------------------------------------------------------------
// Constants
//-----------------------------------------------------------------------

//-----------------------------------------------------------------------
// Private variables
//-----------------------------------------------------------------------

//-----------------------------------------------------------------------
// Private (Internal) functions
//-----------------------------------------------------------------------

//-----------------------------------------------------------------------
// Public functions
//-----------------------------------------------------------------------
