aaronbeekay/Battery-balancer/(commit log)

2016-01-19 Fix incorrect cell internal resistance. Add lockout parameter for recently balanced cells.
2016-01-19 Add stats to cell voltage plot.
2016-01-19 Model charger constant-voltage mode. Add charge+balance finished detection. Stop simulation if charge+balance finished.
2016-01-24 Added CCS TI RTOS project to repo that will be used for battery balancer software
    [app.cfg]
2016-01-24 draft HMI behavior & ignore Excel temp files
    [HMI behavior.xlsx]
2016-01-24 Started file structure, small bits of implementation
    [app.cfg, app_p28L.cfg, build.cfg]
2016-01-25 Added state machine functionality. Added Hex Encoder functionality code for testing purposes. Will be used to simulate switch that will change between charge, balance, and charge and balance state
    [app.cfg, app_p28L.cfg, build.cfg]
2016-01-27 first draft front panel schematic
    [Front panel PCB.brd, Front panel PCB.sch]
2016-01-27 Sketch out CAD of front panel
    [Front panel PCB mount.SLDPRT, Front panel PCB.SLDPRT, Front panel.SLDASM, Front panel.SLDPRT, GCX3131 E-stop button.SLDPRT, GCX3202 pushbutton ind.SLDPRT, GCX3320 selector switch.sldprt, LCD.SLDPRT]
2016-01-27 Continued implementation. Added function prototype for CAN receive interrupt
    [app.cfg, app_p28L.cfg, build.cfg]
2016-01-27 add ALARM and THERMISTOR connectors, adjust layout
    [Front panel PCB.brd, Front panel PCB.sch]
2016-01-29 Implemented major CAN functionality. Used "swap" MSG ID idea to RTR more messages than available CAN mailboxes. Needs tested.
    [app.cfg]
2016-01-29 First routing. Passes ERC and DRC.
    [Front panel PCB.brd, Front panel PCB.sch]
2016-01-29 Add board labels and create documentation
    [Front panel PCB.brd, Front panel PCB.sch]
2016-01-29 Select components
    [Front panel PCB.brd, Front panel PCB.sch, Thermistor calculations.xlsx]
2016-01-30 Add solder jumpers for I2C address
    [Front panel PCB.brd, Front panel PCB.sch]
2016-01-31 Fixed CAN implementation. Bug: Will successfully RTR every second for the BIM cell stats. The code will also receive data on those IDs but will then stop RTRing.
    [app.cfg]
2016-01-31 Fixed CAN receive and RTR Failure. Operation may not currently be up to spec.
    [app.cfg]
2016-02-01 Move !GPIO_INT to GP0 for routing reasons. Add low-side relay drive for balance enable relay.
    [Front panel PCB.brd, Front panel PCB.sch]
2016-02-01 Change to SPI interface for clicky boards and start routing
    [Front panel PCB.brd, Front panel PCB.sch]
2016-02-02 Finalize routing; generate documentation; generate BOM. This commit passes DRC
    [Front panel PCB BOM.csv, Front panel PCB.brd, Front panel PCB.sch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]
2016-02-02 Add design calculations
    [SPIBRR calculations.xlsx, Thermistor calculations.xlsx]
2016-02-02 Fix a problem where the schematic was ugly
    [Front panel PCB.brd, Front panel PCB.sch]
2016-02-02 Update barrel jack package to allow mfg at Advanced Circuits
    [Front panel PCB.brd, Front panel PCB.sch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]
2016-02-03 Resolve ERC warnings in schematic
    [Front panel PCB.sch]
2016-02-03 Added first attempt at I2C implementation w/o ability to test with TCA9555
2016-03-11 assembly BOM for front panel board
    [Front panel assembly BOM.xlsx]
2016-03-11 prototype CAD of balancer enclosure
    [Balancer enclosure.SLDASM, Fan Housing.sldprt, Fan.sldprt, Ohmite L25J1R0E.SLDPRT, Resistor side wall.SLDPRT, SUNON Fan Assembly.SLDASM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]
2016-03-11 Prototype CAD of front panel board
    [Foot thing.SLDPRT, Foot thing.STL, Front panel PCB mount.SLDPRT, Front panel PCB mount.STL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]
2016-03-22 Update front panel for rack mounting. Add panel meters.
    [Front panel.SLDASM, Front panel.SLDDRW, Front panel.SLDPRT, Panel meter PM89.SLDPRT]
